NadeenHamdy/Raptor-robot/Big robot photo.png

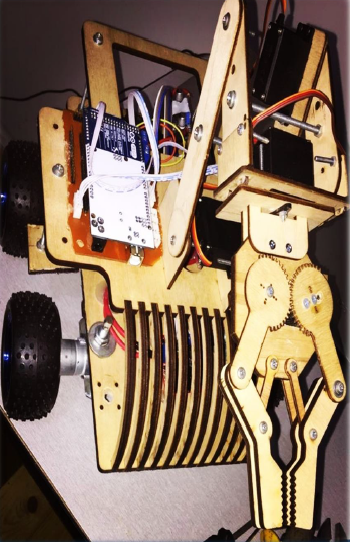
Big robot photo.png
