NadeenHamdy/Raptor-robot/Mini robot photo.png

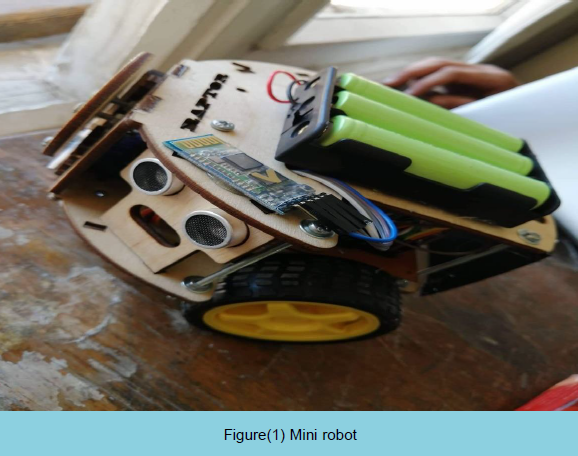
Mini robot photo.png
