NadeenHamdy/Raptor-robot/untitled2.brd

## EAGLE design untitled2.brd (2021-08-30)

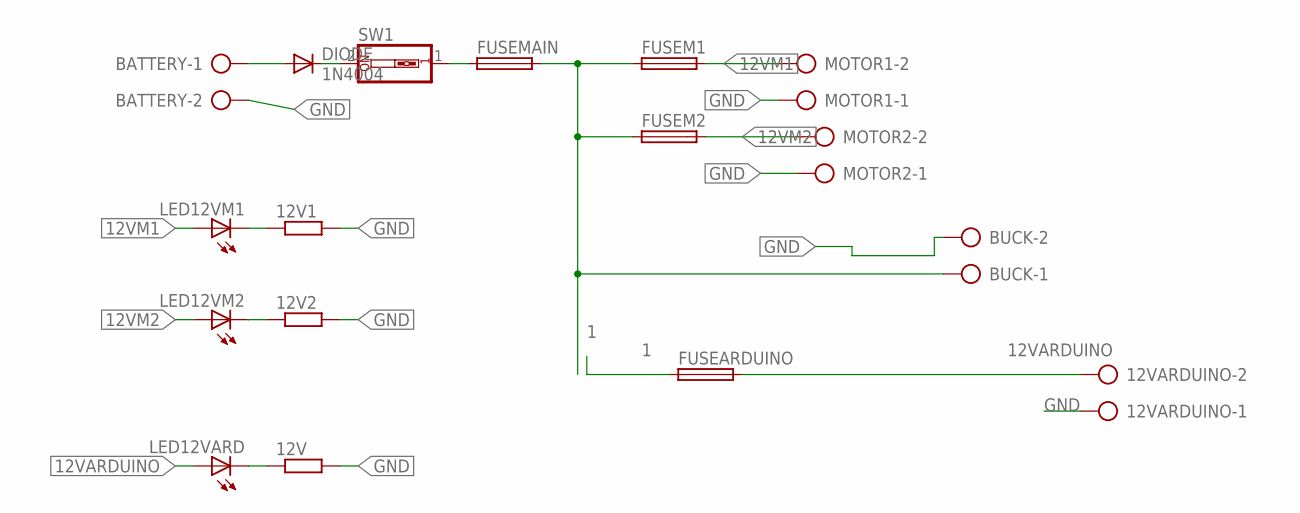
[picture p43: schematic untitled2.sch]

Parts:
12V, 12V1, 12V2: R-EU_0204/7; 0204/7
12VARDUINO: AK500/2-H
BATTERY: AK500/2-H
BUCK: AK500/2-H
DIODE: 1N4004; DO41-10
FUSEARDUINO: SH22,5
FUSEM1, FUSEM2: SH22,5
FUSEMAIN: SH22,5
LED12VARD, LED12VM1, LED12VM2: LEDLSU260; LSU260
MOTOR1, MOTOR2: AK500/2-H
SW1: SW_DIP-1; EDG-01

Connections:
1: BUCK.1, FUSEARDUINO.1, FUSEM1.1, FUSEM2.1, FUSEMAIN.2
12VARDUINO: 12VARDUINO.2, FUSEARDUINO.2, LED12VARD.A
12VM1: FUSEM1.2, LED12VM1.A, MOTOR1.2
12VM2: FUSEM2.2, LED12VM2.A, MOTOR2.2
GND: 12V.2, 12V1.2, 12V2.2, 12VARDUINO.1, BATTERY.2, BUCK.2, MOTOR1.1, MOTOR2.1
unnamed: BATTERY.1, DIODE.A
unnamed: DIODE.C, SW1.2
unnamed: FUSEMAIN.1, SW1.1
unnamed: 12V2.1, LED12VM2.K (C)
unnamed: 12V1.1, LED12VM1.K (C)
unnamed: 12V.1, LED12VARD.K (C)

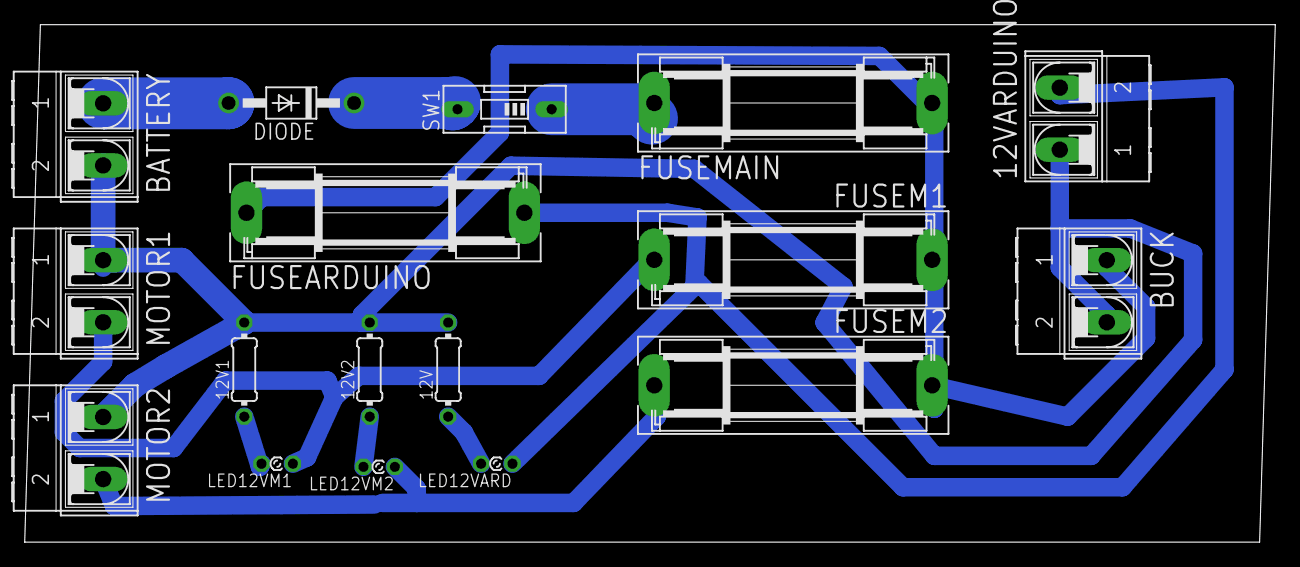
[picture p44: board untitled2.brd from above]

Board: 2 copper layers, 101.3 x 41.9 mm, 17 parts (0 on the bottom side), 11 nets.
