NadeenHamdy/Raptor-robot/PCB designs/big shield.brd

## EAGLE design PCB designs/big shield.brd (2021-08-30)

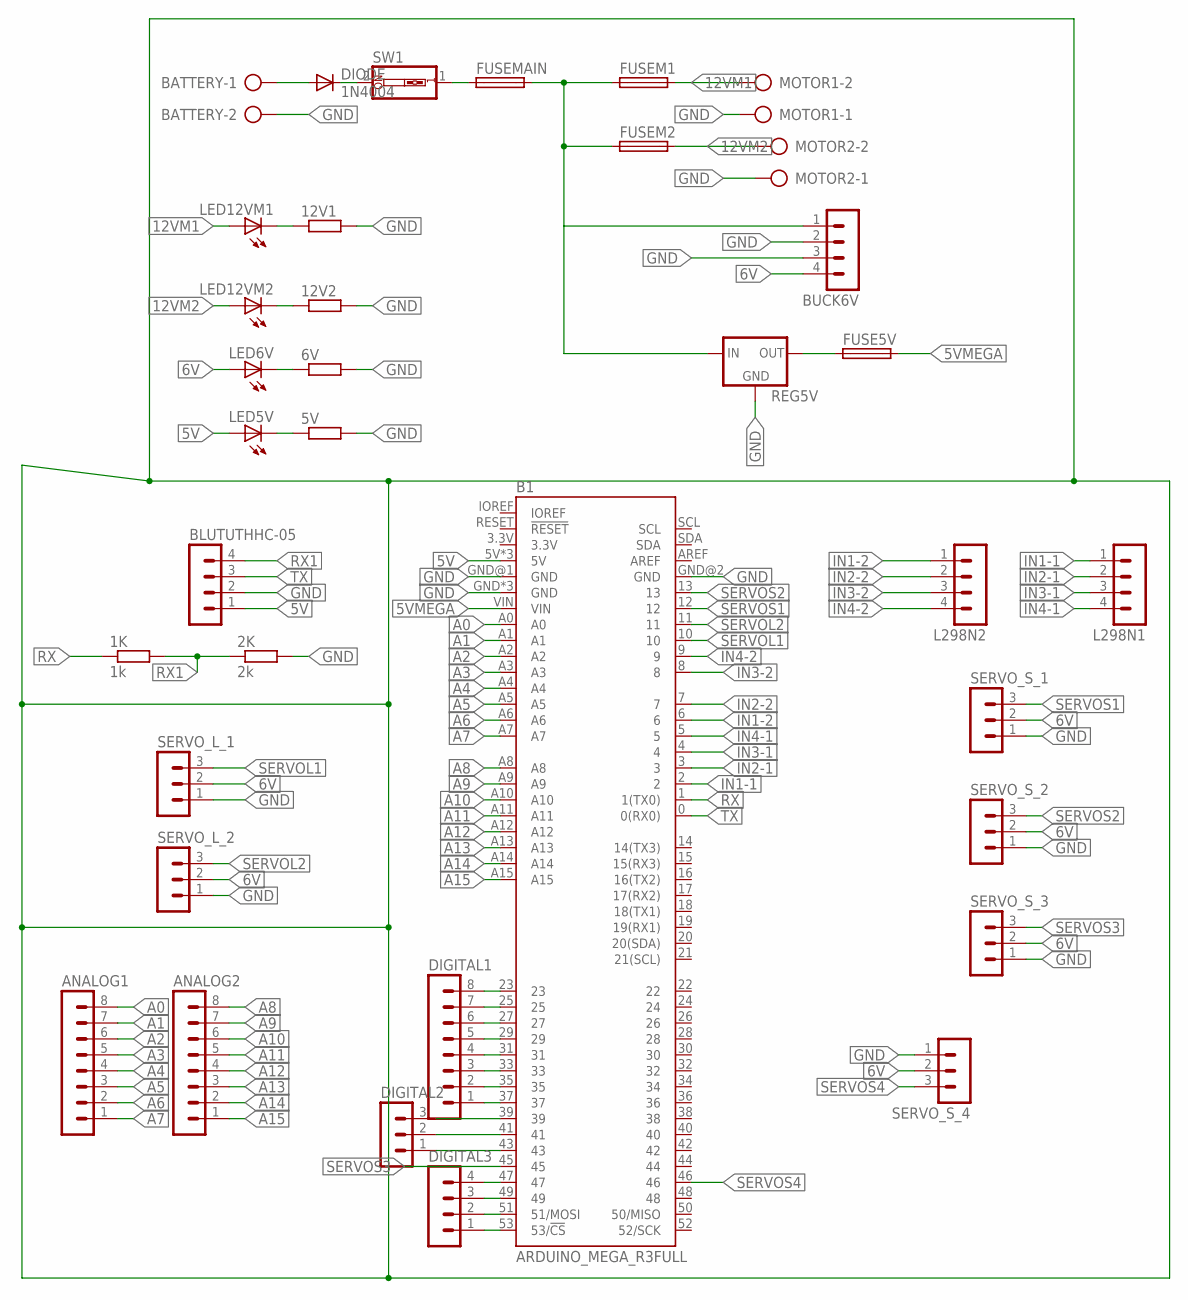
[picture p45: schematic big shield.sch]

Parts:
1K: 1k; 0207/10
2K: 2k; 0207/10
5V, 6V, 12V1, 12V2: R-EU_0204/7; 0204/7
ANALOG1, ANALOG2: MA08-1
B1: ARDUINO_MEGA_R3FULL; ARDUINO_MEGA_NO_SILK
BATTERY: AK500/2-H
BLUTUTHHC-05: MA04-1
BUCK6V: MA04-1
DIGITAL1: MA08-1
DIGITAL2: MA03-1
DIGITAL3: MA04-1
DIODE: 1N4004; DO41-10
FUSE5V: SH22,5
FUSEM1, FUSEM2: SH22,5
FUSEMAIN: SH22,5
L298N1, L298N2: MA04-1
LED5V, LED6V, LED12VM1, LED12VM2: LEDLSU260; LSU260
MOTOR1, MOTOR2: AK500/2-H
REG5V: 78XXS
SERVO_L_1, SERVO_L_2: MA03-1
SERVO_S_1, SERVO_S_2, SERVO_S_3, SERVO_S_4: MA03-1
SW1: SW_DIP-1; EDG-01

Connections:
5V: B1.5V, B1.5V@1 (5V), B1.5V@2 (5V), BLUTUTHHC-05.1, LED5V.A
5VMEGA: B1.VIN, FUSE5V.2
6V: BUCK6V.4, LED6V.A, SERVO_L_1.2, SERVO_L_2.2, SERVO_S_1.2, SERVO_S_2.2, SERVO_S_3.2, SERVO_S_4.2
12V1: BUCK6V.1, FUSEM1.1, FUSEM2.1, FUSEMAIN.2, REG5V.IN
12VM1: FUSEM1.2, LED12VM1.A, MOTOR1.2
12VM2: FUSEM2.2, LED12VM2.A, MOTOR2.2
A0: ANALOG1.8, B1.A0
A1: ANALOG1.7, B1.A1
A2: ANALOG1.6, B1.A2
A3: ANALOG1.5, B1.A3
A4: ANALOG1.4, B1.A4
A5: ANALOG1.3, B1.A5
A6: ANALOG1.2, B1.A6
A7: ANALOG1.1, B1.A7
A8: ANALOG2.8, B1.A8
A9: ANALOG2.7, B1.A9
A10: ANALOG2.6, B1.A10
A11: ANALOG2.5, B1.A11
A12: ANALOG2.4, B1.A12
A13: ANALOG2.3, B1.A13
A14: ANALOG2.2, B1.A14
A15: ANALOG2.1, B1.A15
GND: 2K.2, 5V.2, 6V.2, 12V1.2, 12V2.2, B1.GND, B1.GND@1 (GND), B1.GND@2 (GND), B1.GND@3 (GND), B1.GND@4 (GND), BATTERY.2, BLUTUTHHC-05.2, BUCK6V.2, BUCK6V.3, MOTOR1.1, MOTOR2.1, REG5V.GND, SERVO_L_1.1, SERVO_L_2.1, SERVO_S_1.1, SERVO_S_2.1, SERVO_S_3.1, SERVO_S_4.1
IN1-1: B1.2, L298N1.1
IN1-2: B1.6, L298N2.1
IN2-1: B1.3, L298N1.2
IN2-2: B1.7, L298N2.2
IN3-1: B1.4, L298N1.3
IN3-2: B1.8, L298N2.3
IN4-1: B1.5, L298N1.4
IN4-2: B1.9, L298N2.4
unnamed: BATTERY.1, DIODE.A
unnamed: DIODE.C, SW1.2
unnamed: FUSEMAIN.1, SW1.1
unnamed: FUSE5V.1, REG5V.OUT
unnamed: 6V.1, LED6V.K (C)
unnamed: 12V2.1, LED12VM2.K (C)
unnamed: 12V1.1, LED12VM1.K (C)
unnamed: 5V.1, LED5V.K (C)
unnamed: B1.23, DIGITAL1.8
unnamed: B1.25, DIGITAL1.7
unnamed: B1.27, DIGITAL1.6
unnamed: B1.29, DIGITAL1.5
unnamed: B1.31, DIGITAL1.4
unnamed: B1.33, DIGITAL1.3
unnamed: B1.35, DIGITAL1.2
unnamed: B1.37, DIGITAL1.1
unnamed: B1.39, DIGITAL2.3
unnamed: B1.41, DIGITAL2.2
unnamed: B1.43, DIGITAL2.1
unnamed: B1.47, DIGITAL3.4
unnamed: B1.49, DIGITAL3.3
unnamed: B1.51 (51/MOSI), DIGITAL3.2
unnamed: B1.53 (53/!CS), DIGITAL3.1
RX: 1K.1, B1.1 (1(TX0))
RX1: 1K.2, 2K.1, BLUTUTHHC-05.4
SERVOL1: B1.10, SERVO_L_1.3
SERVOL2: B1.11, SERVO_L_2.3
SERVOS1: B1.12, SERVO_S_1.3
SERVOS2: B1.13, SERVO_S_2.3
SERVOS3: B1.45, SERVO_S_3.3
SERVOS4: B1.46, SERVO_S_4.3
TX: B1.0 (0(RX0)), BLUTUTHHC-05.3

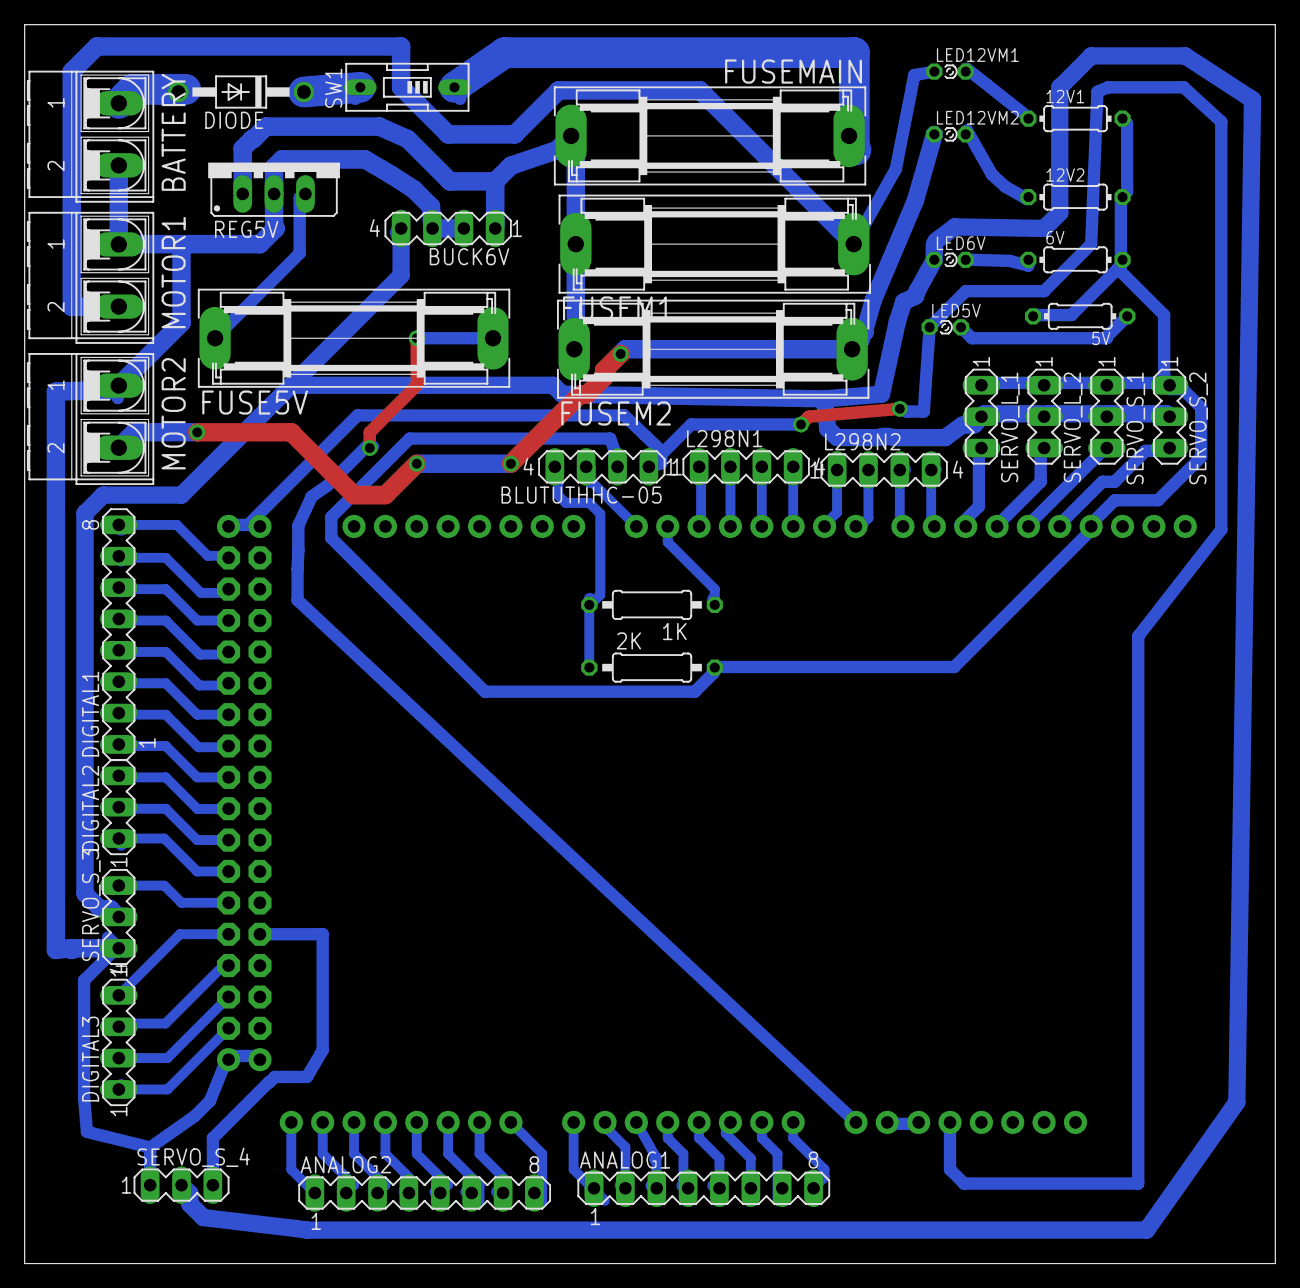
[picture p46: board big shield.brd from above]

Board: 2 copper layers, 101.3 x 100.3 mm, 36 parts (1 on the bottom side), 63 nets.
