NadeenHamdy/Raptor-robot/PCB designs/nano shield.brd

## EAGLE design PCB designs/nano shield.brd (2021-08-30)

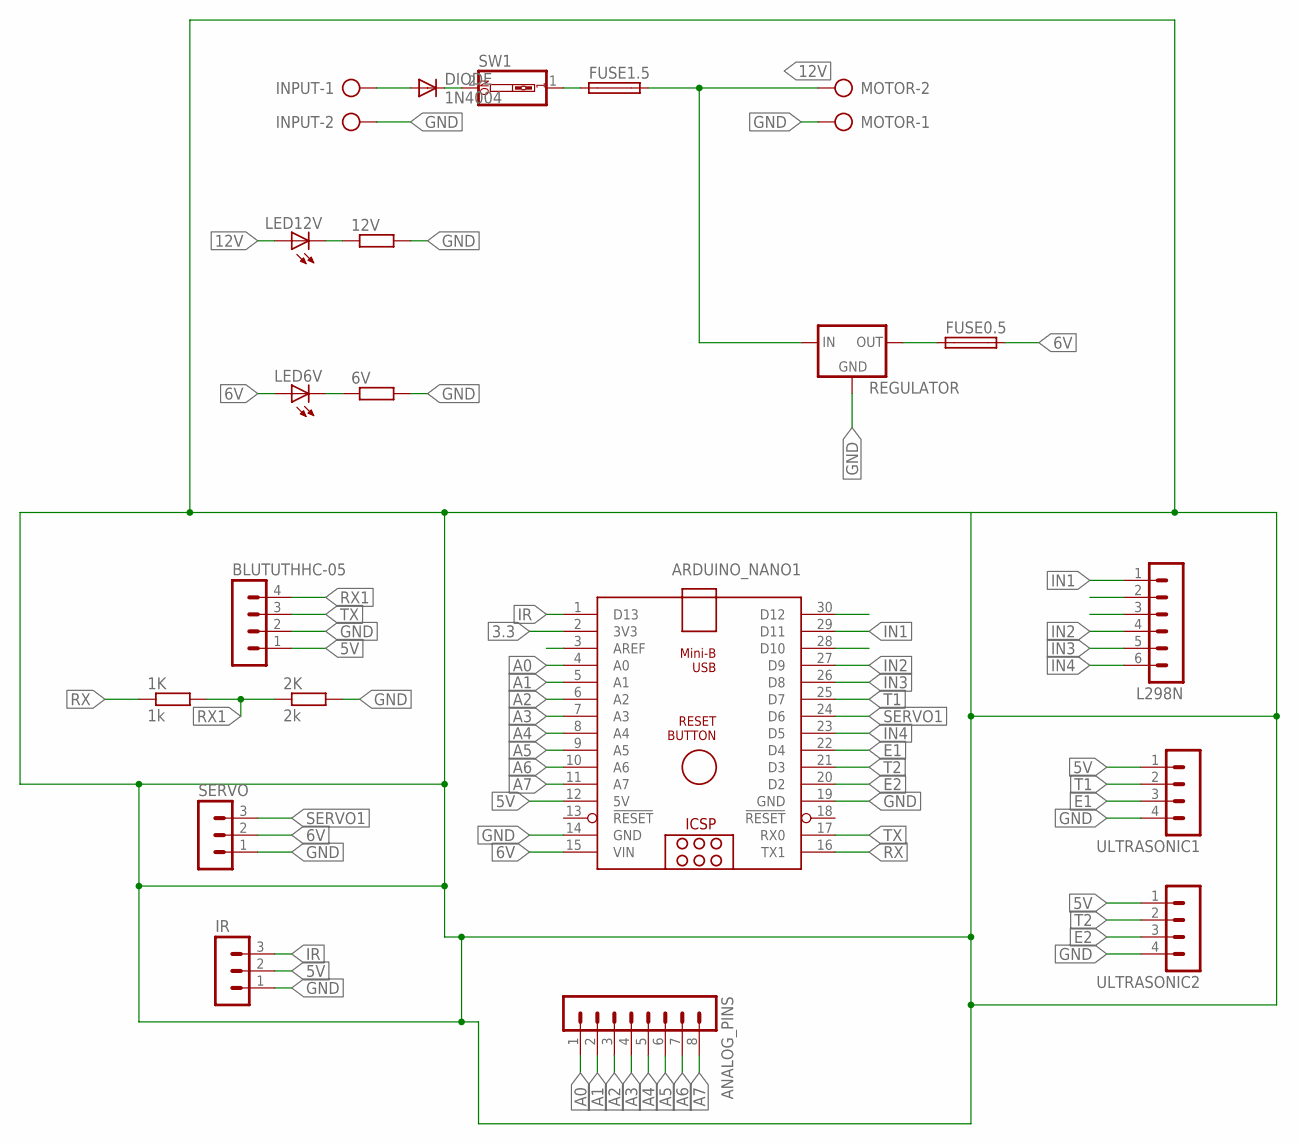
[picture p47: schematic nano shield.sch]

Parts:
1K: 1k; 0207/10
2K: 2k; 0207/10
6V, 12V: R-EU_0204/7; 0204/7
ANALOG_PINS: MA08-1
ARDUINO_NANO1: ARDUINO_NANO
BLUTUTHHC-05: MA04-1
DIODE: 1N4004; DO41-10
FUSE0.5, FUSE1.5: SH22,5
INPUT: AK500/2-H
IR: MA03-1
L298N: MA06-1
LED6V, LED12V: LEDLSU260; LSU260
MOTOR: AK500/2-H
REGULATOR: 78XXS
SERVO: MA03-1
SW1: SW_DIP-1; EDG-01
ULTRASONIC1, ULTRASONIC2: MA04-1

Connections:
3.3: ARDUINO_NANO1.2 (3V3)
5V: ARDUINO_NANO1.12 (5V), BLUTUTHHC-05.1, IR.2, ULTRASONIC1.1, ULTRASONIC2.1
6V: ARDUINO_NANO1.15 (VIN), FUSE0.5.2, LED6V.A, SERVO.2
12V: FUSE1.5.2, LED12V.A, MOTOR.2, REGULATOR.IN
A0: ANALOG_PINS.1, ARDUINO_NANO1.4 (A0)
A1: ANALOG_PINS.2, ARDUINO_NANO1.5 (A1)
A2: ANALOG_PINS.3, ARDUINO_NANO1.6 (A2)
A3: ANALOG_PINS.4, ARDUINO_NANO1.7 (A3)
A4: ANALOG_PINS.5, ARDUINO_NANO1.8 (A4)
A5: ANALOG_PINS.6, ARDUINO_NANO1.9 (A5)
A6: ANALOG_PINS.7, ARDUINO_NANO1.10 (A6)
A7: ANALOG_PINS.8, ARDUINO_NANO1.11 (A7)
E1: ARDUINO_NANO1.22 (D4), ULTRASONIC1.3
E2: ARDUINO_NANO1.20 (D2), ULTRASONIC2.3
GND: 2K.2, 6V.2, 12V.2, ARDUINO_NANO1.14 (GND), ARDUINO_NANO1.19 (GND), BLUTUTHHC-05.2, INPUT.2, IR.1, MOTOR.1, REGULATOR.GND, SERVO.1, ULTRASONIC1.4, ULTRASONIC2.4
IN1: ARDUINO_NANO1.30 (D12), L298N.1
IN2: ARDUINO_NANO1.27 (D9), L298N.4
IN3: ARDUINO_NANO1.26 (D8), L298N.5
IN4: ARDUINO_NANO1.23 (D5), L298N.6
IR: ARDUINO_NANO1.1 (D13), IR.3
unnamed: DIODE.A, INPUT.1
unnamed: DIODE.C, SW1.2
unnamed: FUSE1.5.1, SW1.1
unnamed: FUSE0.5.1, REGULATOR.OUT
unnamed: 6V.1, LED6V.K (C)
unnamed: 12V.1, LED12V.K (C)
PWM1: ARDUINO_NANO1.29 (D11), L298N.2
PWM2: ARDUINO_NANO1.28 (D10), L298N.3
RX: 1K.1, ARDUINO_NANO1.16 (TX1)
RX1: 1K.2, 2K.1, BLUTUTHHC-05.4
SERVO1: ARDUINO_NANO1.24 (D6), SERVO.3
T1: ARDUINO_NANO1.25 (D7), ULTRASONIC1.2
T2: ARDUINO_NANO1.21 (D3), ULTRASONIC2.2
TX: ARDUINO_NANO1.17 (RX0), BLUTUTHHC-05.3

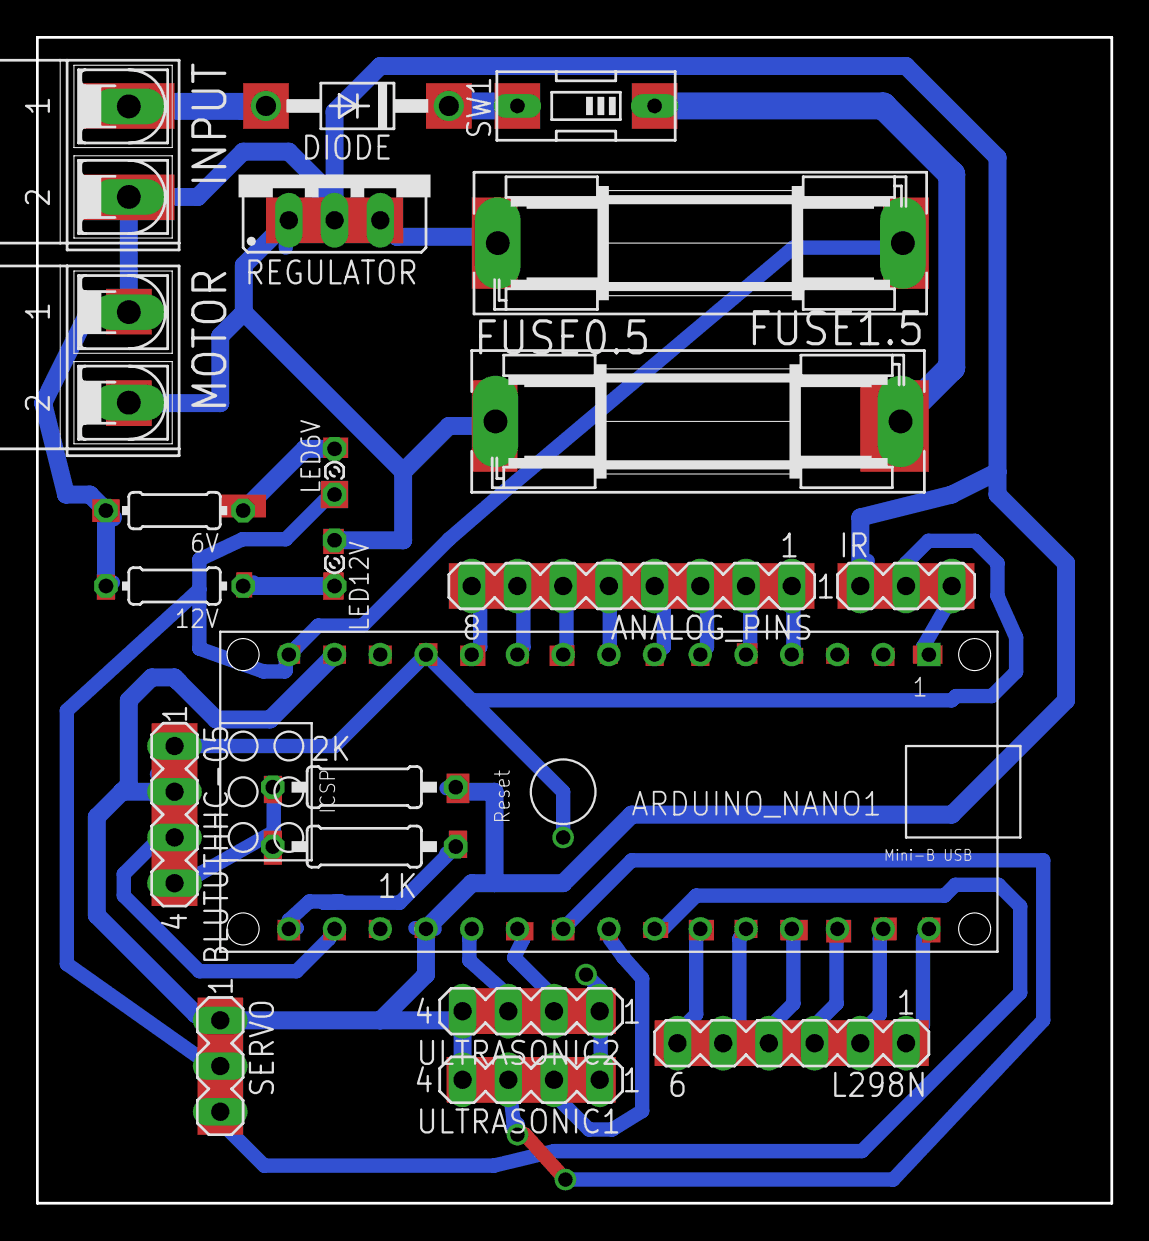
[picture p48: board nano shield.brd from above]

Board: 2 copper layers, 59.7 x 64.8 mm, 21 parts (0 on the bottom side), 33 nets.
